swindonmakers/SCOB/README.md

# SCOB
BOB-inspired mobile robot designed in OpenSCAD

[Full assembly, printing and sourcing guides in the documentation](http://rawgit.com/snhack/SCOB/master/hardware/docs/index.htm)

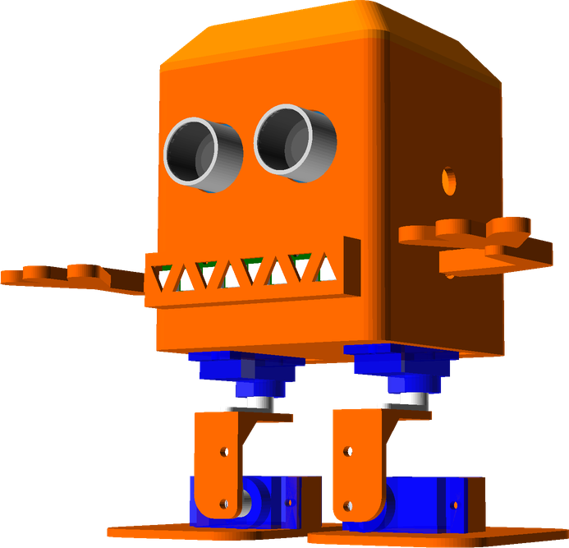
[picture p1: hardware/images/SCOB_view.png]
