swindonmakers/SCOB/hardware/docs/SCOBSourcingGuide.md

# SCOB
# Sourcing Guide

### 1x Arduino Pro Mini Pins on top, inc serial pins

Unit Cost | Source | Notes 
--- | --- | --- 
3 | [link](http://www.aliexpress.com/item/CP2102-Module-Pro-Mini-Module-Atmega328-3-3V-8M-For-Arduinoi-Compatible-With-Nano-Free-Shipping/2002847394.html) | Use 3.3v version for wider compatibility and longer battery life

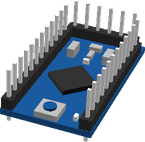
[picture p6: hardware/vitamins/images/ArduinoProMiniPinsontopincserialpins_view.png]
 

### 4x AA Battery

Unit Cost | Source | Notes 
--- | --- | --- 
0.35 | All over the place | Use rechargeables to save cost

 

### 1x Battery Pack

Unit Cost | Source | Notes 
--- | --- | --- 
0.49 | [link](http://www.aliexpress.com/item/Black-Color-2-2-AA-Battery-1-5V-Holder-Storage-Boxes-for-DIY-Experiment-Test-Cascade/1981330624.html) | Any 4xAA pack should work fine, or use 2S LIPO, NIMH, NICAD, etc

 

### 1x HCSR04 Ultrasonic Sensor

No sources found

 

### 4x 9g Micro Servo

No sources found

 

### 1x SPST6A Mini Toggle Switch

Unit Cost | Source | Notes 
--- | --- | --- 
0.56 | [link](http://www.ebay.co.uk/itm/10x-Mini-Toggle-Switch-6A-SPST-ON-OFF-/251443706793?) | Buy in bulk x10

 

### 1x NeoPixel Strip8

No sources found

 

### 4x Servo Horn

No sources found

 

## Summary

### Total Costs

Metric | Value 
--- | --- 
Total Vitamins | 17
Total Cost (cheapest) | 5.45 GBP
