swindonmakers/SCOB/hardware/docs/BOBOSourcingGuide.md

# BOBO
# Sourcing Guide

### 1x Arduino Pro Mini Pins underneath, inc serial pins

No sources found

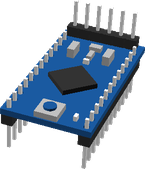
[picture p7: hardware/vitamins/images/ArduinoProMiniPinsunderneathincserialpins_view.png]
 

### 4x AAA Battery

No sources found

 

### 1x HCSR04 Ultrasonic Sensor

No sources found

 

### 2x 9g Micro Servo

No sources found

 

### 1x SPST6A Mini Toggle Switch

Unit Cost | Source | Notes 
--- | --- | --- 
0.56 | [link](http://www.ebay.co.uk/itm/10x-Mini-Toggle-Switch-6A-SPST-ON-OFF-/251443706793?) | Buy in bulk x10

 

## Summary

### Total Costs

Metric | Value 
--- | --- 
Total Vitamins | 9
Total Cost (cheapest) | 0.56 GBP
