swindonmakers/SCOB/hardware/printedparts/stl/NeoPixelMouth.stl

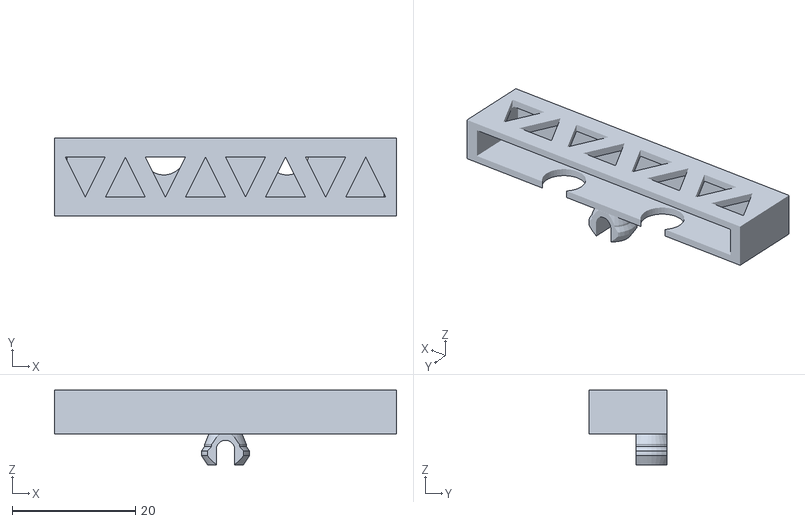
[picture p8: CAD file, 2015-09-18]
hardware/printedparts/stl/NeoPixelMouth.stl
55.5 x 12.7 x 12.2
