swindonmakers/SCOB/hardware/ref/Base__repaired_.stl

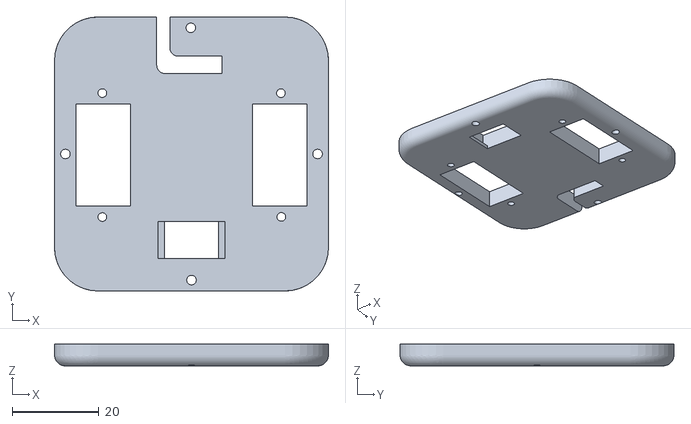
[picture p9: CAD file, 2015-08-27]
hardware/ref/Base__repaired_.stl
63.0 x 63.0 x 5.00
