swindonmakers/SCOB/hardware/utils/surfacesolids/curve_section.stl

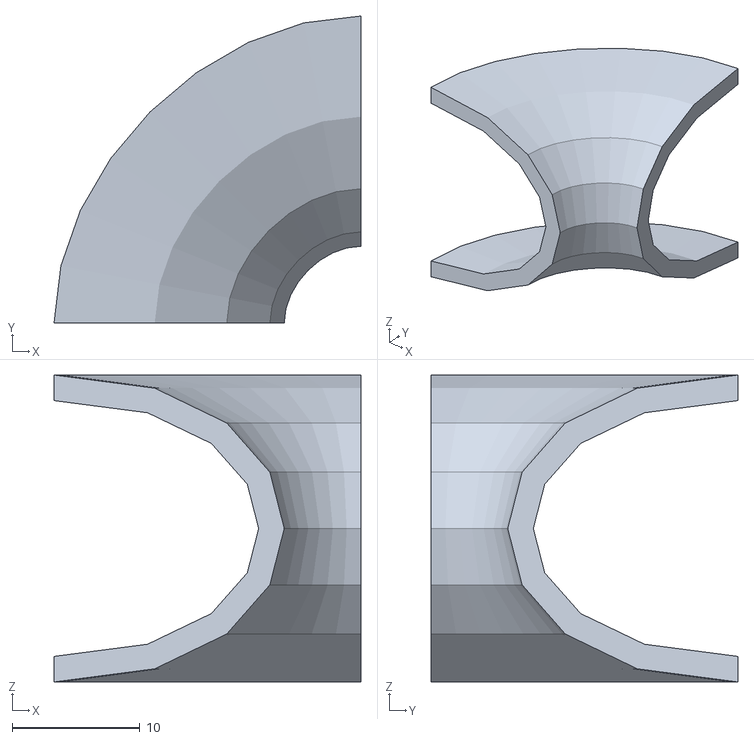
[picture p10: CAD file, 2015-08-27]
hardware/utils/surfacesolids/curve_section.stl
24.0 x 24.0 x 24.0
