swindonmakers/SCOB/hardware/vitamins/stl/ServoHorn_Part.stl

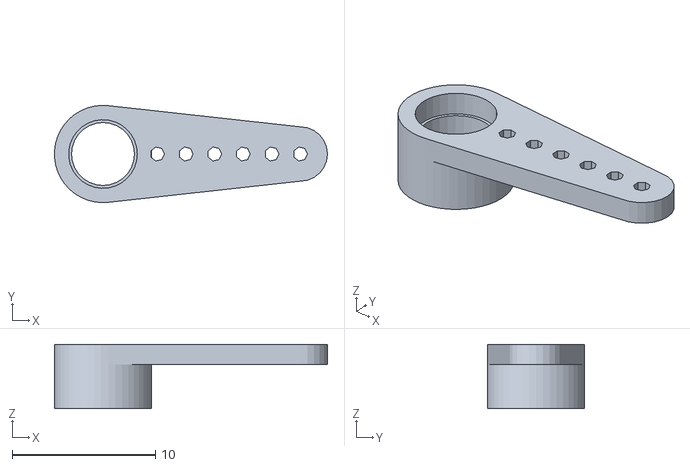
[picture p11: CAD file, 2015-11-09]
hardware/vitamins/stl/ServoHorn_Part.stl
19.1 x 6.80 x 4.50
