swindonmakers/SCOB/hardware/printedparts/stl/ZombieArm.stl

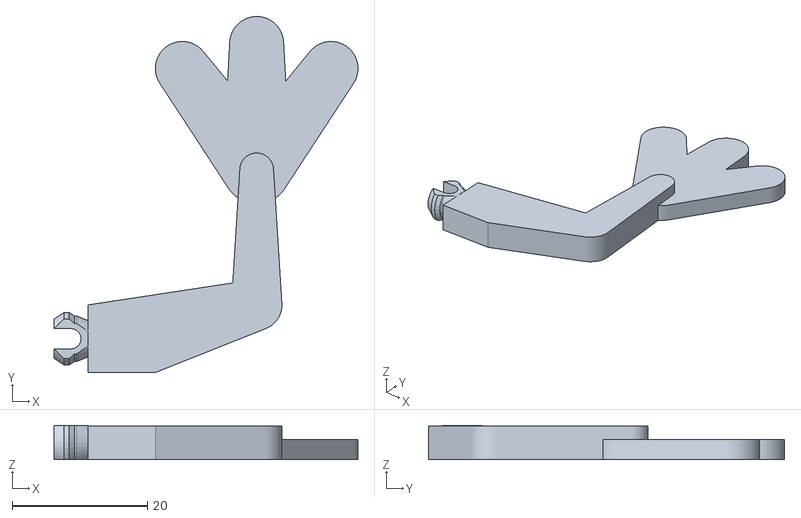
[picture p12: CAD file, 2015-09-18]
hardware/printedparts/stl/ZombieArm.stl
45.0 x 52.7 x 5.05
