swindonmakers/SCOB/hardware/ref/Head__repaired_.stl

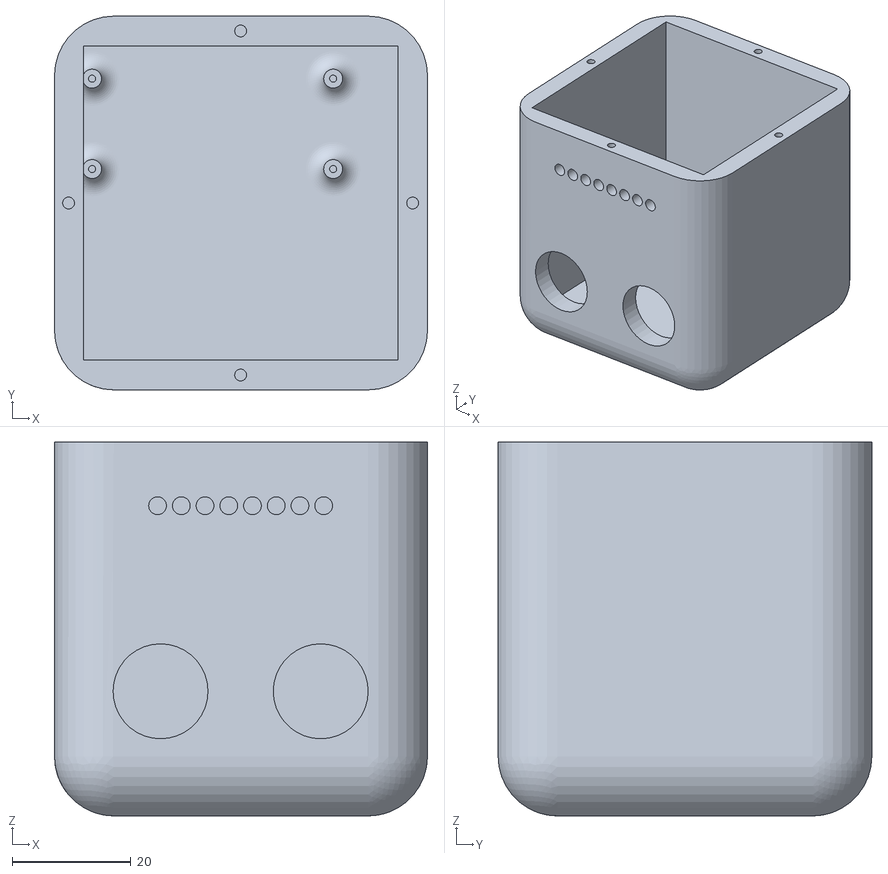
[picture p13: CAD file, 2015-08-27]
hardware/ref/Head__repaired_.stl
62.9 x 63.0 x 63.0
