swindonmakers/SCOB/hardware/vitamins/stl/MicroServo_Body.stl

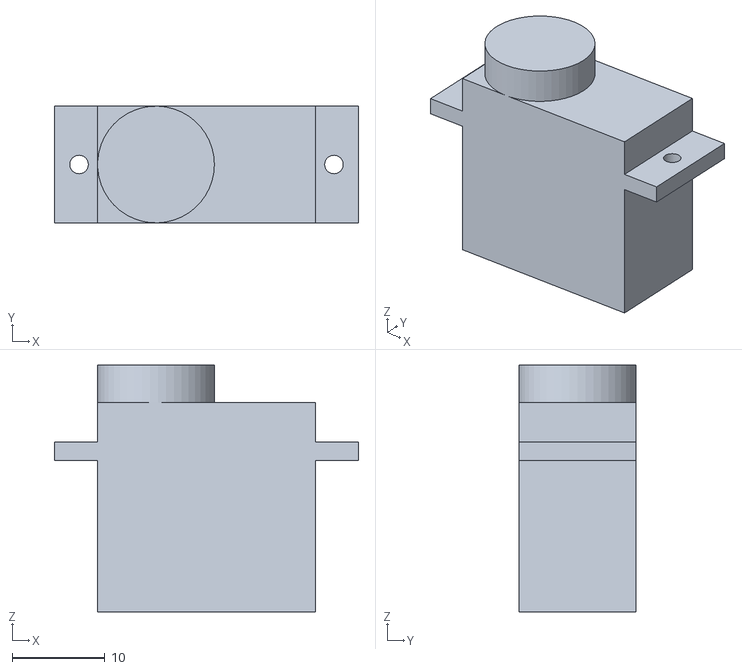
[picture p14: CAD file, 2015-08-27]
hardware/vitamins/stl/MicroServo_Body.stl
32.8 x 12.6 x 26.6
