swindonmakers/SCOB/hardware/printedparts/stl/FlexyArm.stl

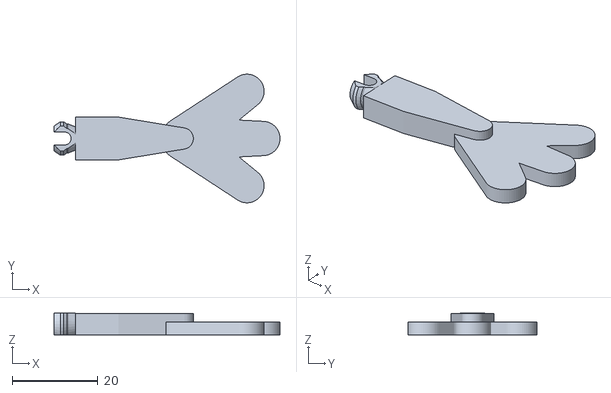
[picture p15: CAD file, 2015-09-18]
hardware/printedparts/stl/FlexyArm.stl
52.7 x 30.0 x 5.05
