swindonmakers/SCOB/hardware/ref/Foot__repaired_.stl

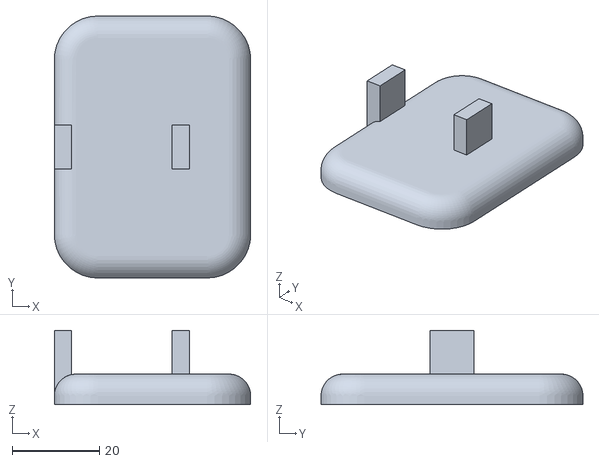
[picture p16: CAD file, 2015-08-27]
hardware/ref/Foot__repaired_.stl
45.0 x 60.0 x 17.0
