swindonmakers/SCOB/hardware/vitamins/stl/MicroServo_Spline.stl

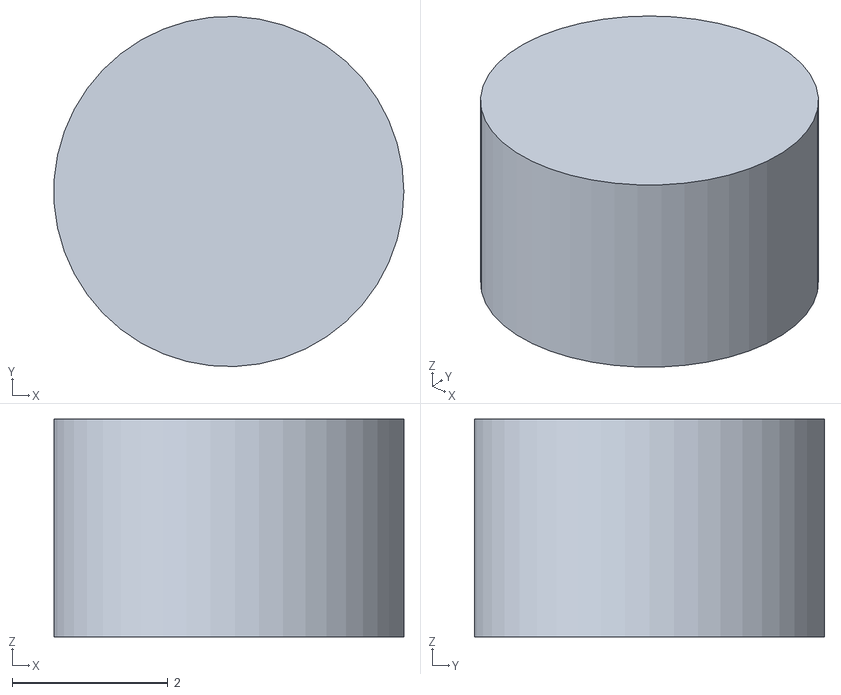
[picture p17: CAD file, 2015-08-27]
hardware/vitamins/stl/MicroServo_Spline.stl
4.49 x 4.50 x 2.80
