swindonmakers/SCOB/hardware/printedparts/stl/Hat.stl

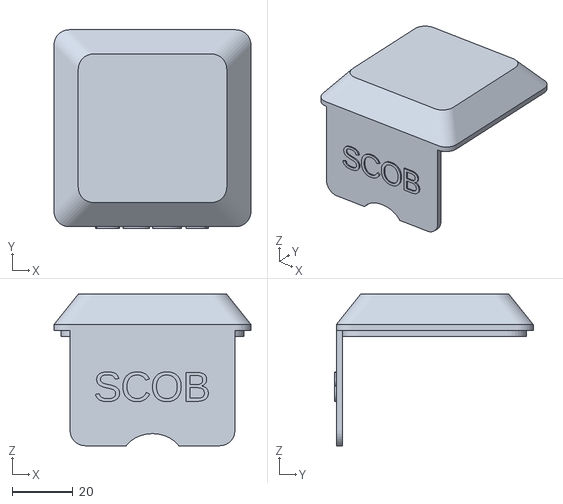
[picture p18: CAD file, 2015-09-18]
hardware/printedparts/stl/Hat.stl
65.0 x 65.5 x 50.0
