swindonmakers/SCOB/hardware/ref/Leg_LH__repaired_.stl

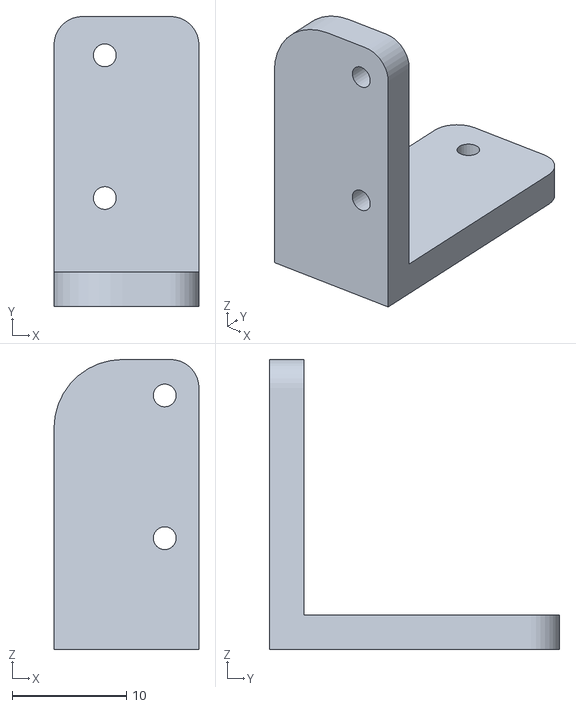
[picture p19: CAD file, 2015-08-27]
hardware/ref/Leg_LH__repaired_.stl
12.7 x 25.4 x 25.4
