swindonmakers/SCOB/hardware/printedparts/stl/Head.stl

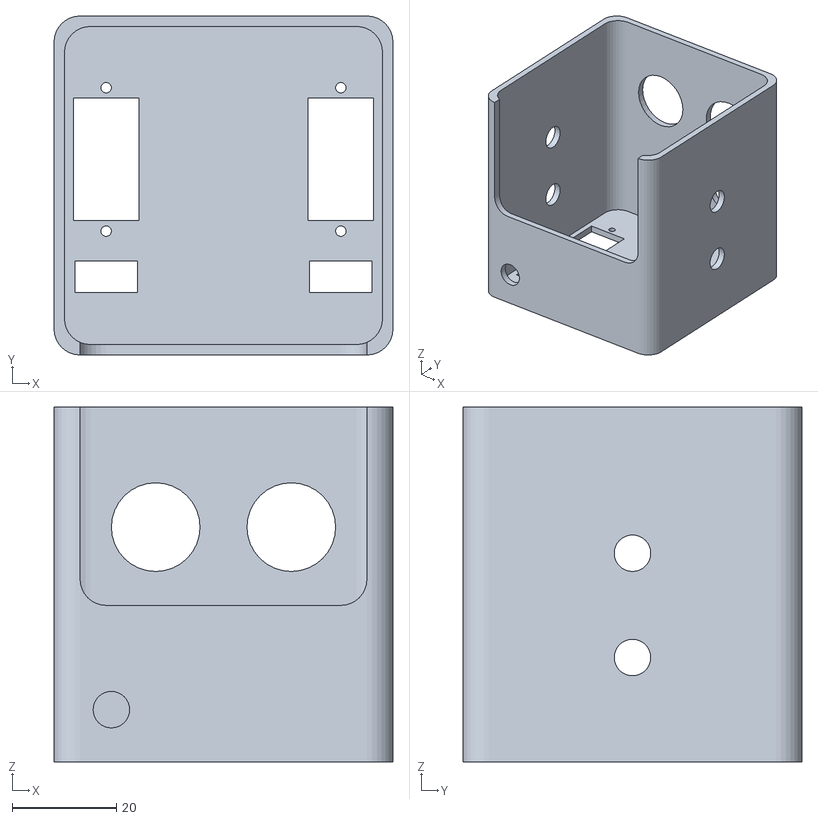
[picture p20: CAD file, 2015-09-18]
hardware/printedparts/stl/Head.stl
65.0 x 65.0 x 68.0
