swindonmakers/SCOB/hardware/printedparts/stl/LeftLeg.stl

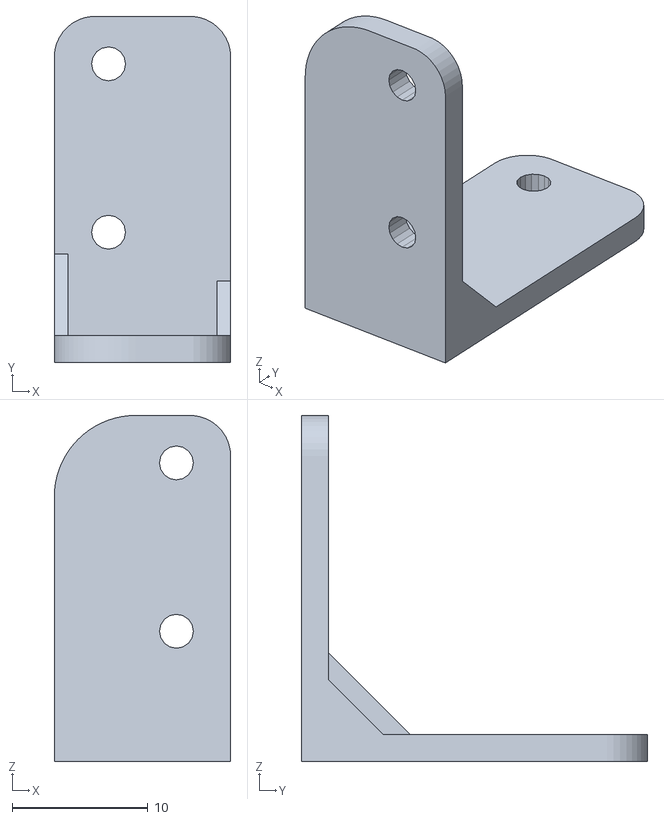
[picture p21: CAD file, 2015-08-28]
hardware/printedparts/stl/LeftLeg.stl
13.0 x 25.5 x 25.5
