swindonmakers/SCOB/hardware/printedparts/stl/Foot.stl

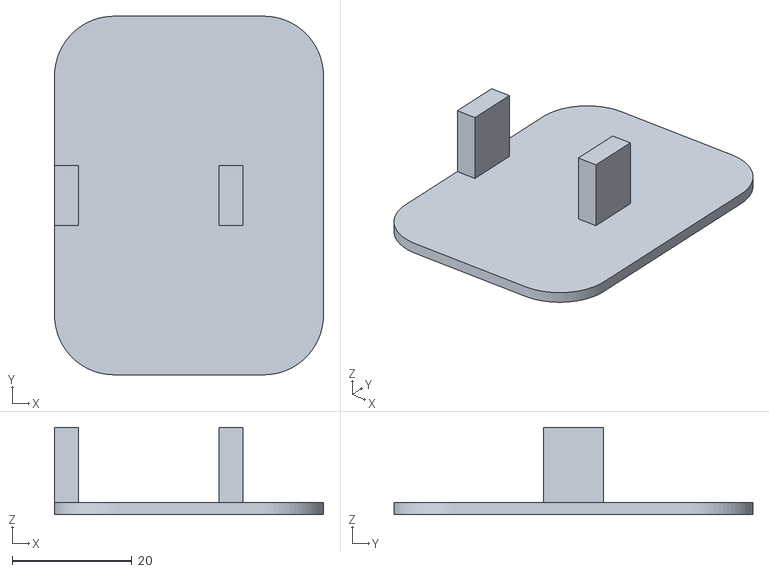
[picture p22: CAD file, 2015-08-28]
hardware/printedparts/stl/Foot.stl
45.0 x 60.0 x 14.6
