swindonmakers/SCOB/hardware/assemblies/Final.scad

Head_Con_Arduino = [[0,0,38], [0,0,-1], 180,0,0];

Head_Con_BatteryPack = [[-8.5,-Head_Depth/2 + 3,24], [0,-1,0], 0,0,0];

module FinalAssembly (zombie=true) {

    assembly("assemblies/Final.scad", "Final", str("FinalAssembly()")) {

        // base part
        Head_STL();

        // steps
        step(1, "Insert sensor") {
            view(t=[0,0,0], r=[52,0,218], d=400);

            attach(Head_Con_SensorTX, HCSR04UltrasonicSensor_Con_TXCan)
                HCSR04UltrasonicSensor();
        }

        // insert left servo
        step(2, "Left servo") {
            view();

            attach(Head_Con_LeftServo, MicroServo_Con_Fixing1) {
                MicroServo();
                attach(MicroServo_Con_Horn, DefConDown)
                    ServoHorn();
            }
        }

        // insert right servo
        step(3, "Right servo") {
            view();

            attach(Head_Con_RightServo, MicroServo_Con_Fixing1) {
                MicroServo();
                attach(MicroServo_Con_Horn, DefConDown)
                    ServoHorn();
            }
        }

        step(4, "Power switch") {
            view();

            attach(Head_Con_PowerSwitch, MiniToggleSwitch_Con_Def)
                MiniToggleSwitch(washerOffset=dw);
        }

        step(5, "Shove in an Arduino") {
            view();

            attach(Head_Con_Arduino, ArduinoPro_Con_Center)
                ArduinoPro(headerpins=2, serialpins=1);
        }


        step(6, "Followed by a battery pack") {
            view();

            attach(Head_Con_BatteryPack,DefConDown)
                 BatteryPack(BP=BatteryPack_AA_4_SQ, showBatteries=true);
        }

        step(7, "Attach the legs") {
            view();

            attach(Head_Con_LeftServo, MicroServo_Con_Fixing1) {
                attach(
                    rollConnector(MicroServo_Con_Horn, -90),
                    offsetConnector(invertConnector(LeftLeg_Con_Hip), [0,0,-4.5])
                ) {
                    LeftLeg_STL();

                    attach(LeftLeg_Con_Ankle, LeftFootAssembly_Con_Servo)
                        LeftLegAssembly();
                }

            }

            attach(Head_Con_RightServo, MicroServo_Con_Fixing1) {
                attach(
                    rollConnector(MicroServo_Con_Horn, -90),
                    offsetConnector(invertConnector(RightLeg_Con_Hip), [0,0,-4.5])
                ) {
                    RightLeg_STL();

                    attach(RightLeg_Con_Ankle, RightFootAssembly_Con_Servo)
                        RightLegAssembly();
                }
            }
        }

        step(8, "Add a hat") {
            view();

            attach(Head_Con_Hat, Hat_Con_Def, ExplodeSpacing = 50)
                Hat_STL();
        }

		step(9, "Attach arms") {
			view();

            if (zombie) {
                attach(rollConnector(Head_Con_LeftArm, 180), FlexyArm_Con_Def)
    				ZombieArm_STL();

    			attach(rollConnector(Head_Con_RightArm, 0), FlexyArm_Con_Def)
    				ZombieArm_STL();
            } else {
                attach(rollConnector(Head_Con_LeftArm, -90), FlexyArm_Con_Def)
    				FlexyArm_STL();

    			attach(rollConnector(Head_Con_RightArm, 90), FlexyArm_Con_Def)
    				FlexyArm_STL();
            }

		}
		
		step(10, "Attach mouth") {
			view();
			
			attach(rollConnector(Head_Con_Mouth, 180), NeoPixelMouthAssembly_Con)
				NeoPixelMouthAssembly();
		}
    }
}
