swindonmakers/SCOB/hardware/config/assemblies.scad

//
// Assemblies
//

// Add list of include statements like this:
//include <../assemblies/myassembly.scad>

// Order the include statements such that the lowest sub-assemblies are first
include <../assemblies/Final.scad>
include <../assemblies/LeftLeg.scad>
include <../assemblies/RightLeg.scad>
include <../assemblies/NeoPixelMouth.scad>
