swindonmakers/SCOB/hardware/config/printedparts.scad

// Printed Parts
//
// Order alphabetically - printed parts should not have inter-dependencies!
include <../printedparts/FlexyArm.scad>
include <../printedparts/Head.scad>
include <../printedparts/LeftLeg.scad>
include <../printedparts/RightLeg.scad>
include <../printedparts/Foot.scad>
include <../printedparts/Hat.scad>
include <../printedparts/PinTack.scad>
include <../printedparts/ZombieArm.scad>
include <../printedparts/NeoPixelMouth.scad>
