swindonmakers/SCOB/hardware/config/vitamins.scad

//
// Vitamins

include <../vitamins/HCSR04UltrasonicSensor.scad>
include <../vitamins/MicroServo.scad>
include <../vitamins/MiniToggleSwitch.scad>
include <../vitamins/NeoPixel.scad>
include <../vitamins/ArduinoPro.scad>
include <../vitamins/Battery.scad>
include <../vitamins/BatteryPack.scad>
include <../vitamins/ServoHorn.scad>
