swindonmakers/SCOB/hardware/sandbox/assembly_LeftLegAssembly.scad

include <../config/config.scad>
UseSTL=false;
UseVitaminSTL=true;
DebugConnectors=true;
DebugCoordinateFrames=true;
LeftLegAssembly();
