swindonmakers/SCOB/hardware/sandbox/assembly_RightLegAssembly.scad

include <../config/config.scad>
UseSTL=false;
UseVitaminSTL=true;
DebugConnectors=true;
DebugCoordinateFrames=true;
RightLegAssembly();
