swindonmakers/SCOB/hardware/sandbox/printedpart_FlexyArm.scad

include <../config/config.scad>
UseSTL=false;
UseVitaminSTL=true;
DebugConnectors=true;
DebugCoordinateFrames=true;

FlexyArm_STL();
