swindonmakers/SCOB/hardware/sandbox/printedpart_LeftLeg.scad

include <../config/config.scad>
UseSTL=false;
UseVitaminSTL=true;
DebugConnectors=true;
DebugCoordinateFrames=true;
LeftLeg_STL();
