swindonmakers/SCOB/hardware/sandbox/printedpart_RightLeg.scad

include <../config/config.scad>
UseSTL=false;
UseVitaminSTL=true;
DebugConnectors=true;
DebugCoordinateFrames=true;
RightLeg_STL();
