swindonmakers/SCOB/hardware/sandbox/printedpart_ZombieArm.scad

include <../config/config.scad>
UseSTL=false;
UseVitaminSTL=true;
DebugConnectors=true;
DebugCoordinateFrames=true;
ZombieArm_STL();
