swindonmakers/SCOB/hardware/sandbox/assembly_FinalAssembly.scad

include <../config/config.scad>
UseSTL=false;
UseVitaminSTL=true;
DebugConnectors=true;
DebugCoordinateFrames=true;
FinalAssembly();
