swindonmakers/SCOB/hardware/sandbox/assembly_NeoPixelMouth.scad

include <../config/config.scad>
UseSTL=false;
UseVitaminSTL=true;
DebugConnectors=true;
DebugCoordinateFrames=true;
NeoPixelMouthAssembly();
