swindonmakers/SCOB/hardware/sandbox/printedpart_Foot.scad

include <../config/config.scad>
UseSTL=false;
UseVitaminSTL=true;
DebugConnectors=true;
DebugCoordinateFrames=true;
Foot_STL();
