swindonmakers/SCOB/hardware/sandbox/printedpart_Hat.scad

include <../config/config.scad>
UseSTL=false;
UseVitaminSTL=true;
DebugConnectors=true;
DebugCoordinateFrames=true;
Hat_STL();
