swindonmakers/SCOB/hardware/sandbox/printedpart_Head.scad

include <../config/config.scad>
UseSTL=false;
UseVitaminSTL=true;
DebugConnectors=true;
DebugCoordinateFrames=true;
Head_STL();
