swindonmakers/SCOB/hardware/sandbox/zombieSCOB.scad

include <../config/config.scad>
UseSTL=false;
UseVitaminSTL=true;
DebugConnectors=false;
DebugCoordinateFrames=false;
FinalAssembly(zombie=true);
