swindonmakers/SCOB/(list of files, cad)

Other CAD files:
hardware/ref/Leg_RH__repaired_.stl
hardware/printedparts/stl/RightLeg.stl
hardware/printedparts/RightLeg.scad
hardware/SCOBExtras.scad
hardware/ci/assemblies.scad
hardware/ci/assembly.scad
hardware/ci/cutpart.scad
hardware/ci/cutparts.scad
hardware/ci/machine.scad
hardware/ci/printedpart.scad
hardware/ci/printedparts.scad
hardware/ci/root.scad
hardware/ci/sandbox.scad
hardware/ci/test.scad
hardware/ci/vitamin.scad
hardware/ci/vitamins.scad
hardware/config/colors.scad
hardware/config/config.scad
hardware/config/cutparts.scad
hardware/config/holesizes.scad
hardware/config/utils.scad
hardware/printedparts/PinTack.scad
hardware/utils/assemblies.scad
hardware/utils/bezier.scad
hardware/utils/bezier_demo.scad
hardware/utils/fakeGroundShadow.scad
hardware/utils/maths.scad
hardware/utils/pins.scad
hardware/utils/surfacesolids/Demo_Renderer.scad
hardware/utils/surfacesolids/Renderer.scad
hardware/utils/surfacesolids/maths.scad
hardware/utils/surfacesolids/ribbonCable.scad
hardware/utils/voronoi.scad
hardware/vitamins/ArduinoPro.scad
hardware/vitamins/BatteryPack.scad
hardware/vitamins/Bolt.scad
hardware/vitamins/Breadboard.scad
hardware/vitamins/ESP8266.scad
hardware/vitamins/FTDIBreakout.scad
hardware/vitamins/HookAndLoopTape.scad
hardware/vitamins/JumperWire.scad
hardware/vitamins/LED.scad
hardware/vitamins/LEDClip.scad
hardware/vitamins/LineSensor.scad
hardware/vitamins/Marble.scad
hardware/vitamins/MicroSwitch.scad
hardware/vitamins/MicroUSB.scad
hardware/vitamins/MiniToggleSwitch.scad
hardware/vitamins/Nut.scad
hardware/vitamins/Pen.scad
hardware/vitamins/PlasticCaster.scad
hardware/vitamins/Sharp2Y0A21IrDistanceSensor.scad
hardware/vitamins/SlideSwitch.scad
hardware/vitamins/TerminalBlock.scad
hardware/vitamins/ULN2003DriverBoard.scad
hardware/vitamins/motor.scad
hardware/vitamins/murata-piezos.scad
hardware/vitamins/screw.scad
hardware/vitamins/washer.scad
