swindonmakers/SCOB/hardware/docs/SCOBAssemblyGuide.md

# SCOB
# Assembly Guide

view

## Bill of Materials

Make sure you have all of the following parts before you begin.

### Vitamins

Qty | Vitamin | Image
--- | --- | ---
1 | [Arduino Pro Mini Pins on top, inc serial pins]() |  | 
4 | [AA Battery]() |  | 
1 | [Battery Pack]() |  | 
1 | [HCSR04 Ultrasonic Sensor]() |  | 
4 | [9g Micro Servo]() |  | 
1 | [SPST6A Mini Toggle Switch]() |  | 
1 | [NeoPixel Strip8]() |  | 
4 | [Servo Horn]() |  | 

### Printed Parts

Qty | Part Name | Image
--- | --- | ---
2 | [Foot](../printedparts/stl/Foot.stl) |  | 
1 | [Hat](../printedparts/stl/Hat.stl) |  | 
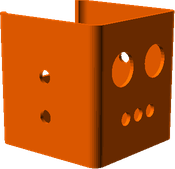
[picture p23: hardware/printedparts/images/Head_view.png]
1 | [Head](../printedparts/stl/Head.stl) |  | 
1 | [Left Leg](../printedparts/stl/LeftLeg.stl) |  | 
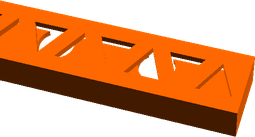
[picture p24: hardware/printedparts/images/NeoPixelMouth_view.png]
1 | [NeoPixelMouth](../printedparts/stl/NeoPixelMouth.stl) |  | 
1 | [Right Leg](../printedparts/stl/RightLeg.stl) |  | 
2 | [Zombie Arm](../printedparts/stl/ZombieArm.stl) |  | 

**Plastic Required**

79.5cm3, 0.1KG,  approx: 1.29 GBP

# Assembly Instructions

## Left Leg

### Vitamins

Qty | Vitamin | Image
--- | --- | ---
1 | [9g Micro Servo]() |  | 
1 | [Servo Horn]() |  | 

### Printed Parts

Qty | Part Name | Image
--- | --- | ---
1 | [Foot](../printedparts/stl/Foot.stl) |  | 

### Assembly Steps

1. Fix servo to foot
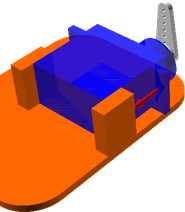
[picture p25: hardware/assemblies/SCOB/LeftLeg_step1_view.png]


## Right Leg

### Vitamins

Qty | Vitamin | Image
--- | --- | ---
1 | [9g Micro Servo]() |  | 
1 | [Servo Horn]() |  | 

### Printed Parts

Qty | Part Name | Image
--- | --- | ---
1 | [Foot](../printedparts/stl/Foot.stl) |  | 

### Assembly Steps

1. Fix servo to foot
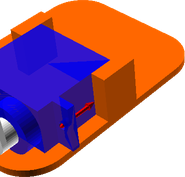
[picture p26: hardware/assemblies/SCOB/RightLeg_step1_view.png]


## Neo Pixel Mouth

### Vitamins

Qty | Vitamin | Image
--- | --- | ---
1 | [NeoPixel Strip8]() |  | 

### Printed Parts

Qty | Part Name | Image
--- | --- | ---
1 | [NeoPixelMouth](../printedparts/stl/NeoPixelMouth.stl) |  | 

### Assembly Steps

1. Insert Neo Pixel Strip
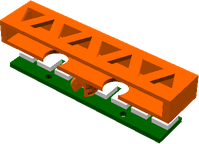
[picture p27: hardware/assemblies/SCOB/NeoPixelMouth_step1_view.png]


## Final

### Vitamins

Qty | Vitamin | Image
--- | --- | ---
1 | [Arduino Pro Mini Pins on top, inc serial pins]() |  | 
4 | [AA Battery]() |  | 
1 | [Battery Pack]() |  | 
1 | [HCSR04 Ultrasonic Sensor]() |  | 
2 | [9g Micro Servo]() |  | 
1 | [SPST6A Mini Toggle Switch]() |  | 
2 | [Servo Horn]() |  | 

### Printed Parts

Qty | Part Name | Image
--- | --- | ---
1 | [Hat](../printedparts/stl/Hat.stl) |  | 
1 | [Head](../printedparts/stl/Head.stl) |  | 
1 | [Left Leg](../printedparts/stl/LeftLeg.stl) |  | 
1 | [Right Leg](../printedparts/stl/RightLeg.stl) |  | 
2 | [Zombie Arm](../printedparts/stl/ZombieArm.stl) |  | 

### Sub-Assemblies

Qty | Name 
--- | --- 
1 | Left Leg
1 | Right Leg
1 | Neo Pixel Mouth

### Assembly Steps

1. Insert sensor
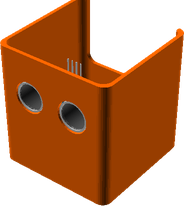
[picture p28: hardware/assemblies/SCOB/Final_step1_view.png]

2. Left servo
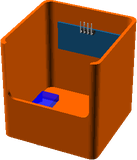
[picture p29: hardware/assemblies/SCOB/Final_step2_view.png]

3. Right servo
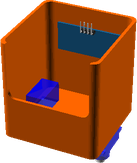
[picture p30: hardware/assemblies/SCOB/Final_step3_view.png]

4. Power switch
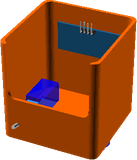
[picture p31: hardware/assemblies/SCOB/Final_step4_view.png]

5. Shove in an Arduino
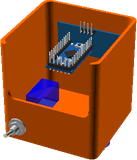
[picture p32: hardware/assemblies/SCOB/Final_step5_view.png]

6. Followed by a battery pack
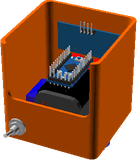
[picture p33: hardware/assemblies/SCOB/Final_step6_view.png]

7. Attach the legs
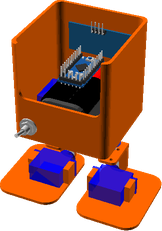
[picture p34: hardware/assemblies/SCOB/Final_step7_view.png]

8. Add a hat
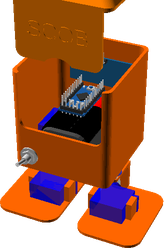
[picture p35: hardware/assemblies/SCOB/Final_step8_view.png]

9. Attach arms
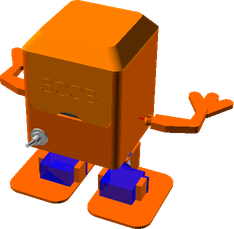
[picture p36: hardware/assemblies/SCOB/Final_step9_view.png]

10. Attach mouth
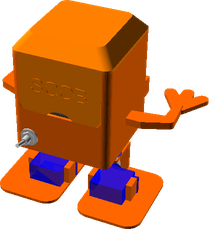
[picture p37: hardware/assemblies/SCOB/Final_step10_view.png]
