swindonmakers/SCOB/hardware/docs/SCOBPrintingGuide.md

# SCOB
# Printing Guide

### Foot

Metric | Value 
--- | --- 
Quantity | 2
STL | [Foot](../printedparts/stl/Foot.stl)
Plastic (Kg) | 0.02
Plastic (cm3) | 13.0
Approx Plastic Cost | 0.24 GBP



### Hat

Metric | Value 
--- | --- 
Quantity | 1
STL | [Hat](../printedparts/stl/Hat.stl)
Plastic (Kg) | 0.02
Plastic (cm3) | 19.4
Approx Plastic Cost | 0.36 GBP



### Head

Metric | Value 
--- | --- 
Quantity | 1
STL | [Head](../printedparts/stl/Head.stl)
Plastic (Kg) | 0.05
Plastic (cm3) | 38.7
Approx Plastic Cost | 0.73 GBP



### Left Leg

Metric | Value 
--- | --- 
Quantity | 1
STL | [Left Leg](../printedparts/stl/LeftLeg.stl)
Plastic (Kg) | 0.0
Plastic (cm3) | 1.3
Approx Plastic Cost | 0.02 GBP



### NeoPixelMouth

Metric | Value 
--- | --- 
Quantity | 1
STL | [NeoPixelMouth](../printedparts/stl/NeoPixelMouth.stl)



### Right Leg

Metric | Value 
--- | --- 
Quantity | 1
STL | [Right Leg](../printedparts/stl/RightLeg.stl)
Plastic (Kg) | 0.0
Plastic (cm3) | 1.3
Approx Plastic Cost | 0.02 GBP



### Zombie Arm

Metric | Value 
--- | --- 
Quantity | 2
STL | [Zombie Arm](../printedparts/stl/ZombieArm.stl)
Plastic (Kg) | 0.01
Plastic (cm3) | 5.8
Approx Plastic Cost | 0.11 GBP



## Summary

### Statistics

Metric | Value 
--- | --- 
Total Parts | 9
Total Plastic (Kg) | 0.1KG
Total Plastic (cm3) | 79.5cm3
Approx Plastic Cost | 1.49 GBP
