swindonmakers/SCOB/hardware/docs/SCOBExtrasAssemblyGuide.md

# SCOB Extras
# Assembly Guide

view

## Bill of Materials

Make sure you have all of the following parts before you begin.

### Printed Parts

Qty | Part Name | Image
--- | --- | ---
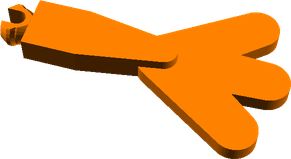
[picture p38: hardware/printedparts/images/FlexyArm_view.png]
1 | [FlexyArm](../printedparts/stl/FlexyArm.stl) |  | 

**Plastic Required**

2.2cm3, 0.0KG,  approx: 0.04 GBP
