swindonmakers/SCOB/hardware/docs/SCOBExtrasPrintingGuide.md

# SCOB Extras
# Printing Guide

### FlexyArm

Metric | Value 
--- | --- 
Quantity | 1
STL | [FlexyArm](../printedparts/stl/FlexyArm.stl)
Plastic (Kg) | 0.0
Plastic (cm3) | 2.2
Approx Plastic Cost | 0.04 GBP



## Summary

### Statistics

Metric | Value 
--- | --- 
Total Parts | 1
Total Plastic (Kg) | 0.0KG
Total Plastic (cm3) | 2.2cm3
Approx Plastic Cost | 0.04 GBP
