swindonmakers/SCOB/hardware/docs/BOBOAssemblyGuide.md

# BOBO
# Assembly Guide

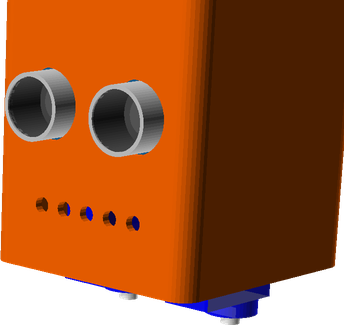
[picture p39: hardware/images/BOBO_view.png]
view


## Bill of Materials

Make sure you have all of the following parts before you begin.

### Vitamins

Qty | Vitamin | Image
--- | --- | ---
1 | [Arduino Pro Mini Pins underneath, inc serial pins]() |  | 
4 | [AAA Battery]() |  | 
1 | [HCSR04 Ultrasonic Sensor]() |  | 
2 | [9g Micro Servo]() |  | 
1 | [SPST6A Mini Toggle Switch]() |  | 

### Printed Parts

Qty | Part Name | Image
--- | --- | ---
1 | [Head](../printedparts/stl/Head.stl) |  | 

**Plastic Required**

38.7cm3, 0.05KG,  approx: 0.63 GBP

# Assembly Instructions

## Final

### Vitamins

Qty | Vitamin | Image
--- | --- | ---
1 | [Arduino Pro Mini Pins underneath, inc serial pins]() |  | 
4 | [AAA Battery]() |  | 
1 | [HCSR04 Ultrasonic Sensor]() |  | 
2 | [9g Micro Servo]() |  | 
1 | [SPST6A Mini Toggle Switch]() |  | 

### Printed Parts

Qty | Part Name | Image
--- | --- | ---
1 | [Head](../printedparts/stl/Head.stl) |  | 

### Assembly Steps

1. Insert sensor
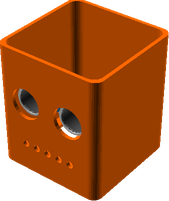
[picture p40: hardware/assemblies/BOBO/Final_step1_view.png]

2. Left servo
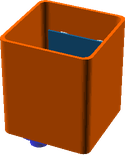
[picture p41: hardware/assemblies/BOBO/Final_step2_view.png]

3. Right servo
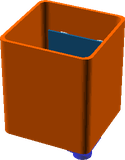
[picture p42: hardware/assemblies/BOBO/Final_step3_view.png]

4. Power switch
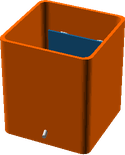
[picture p43: hardware/assemblies/BOBO/Final_step4_view.png]

5. Shove in an Arduino
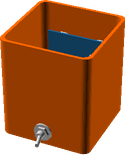
[picture p44: hardware/assemblies/BOBO/Final_step5_view.png]

6. Followed by a battery pack
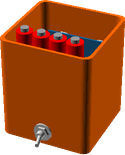
[picture p45: hardware/assemblies/BOBO/Final_step6_view.png]
