swindonmakers/SCOB/hardware/docs/BOBOPrintingGuide.md

# BOBO
# Printing Guide

### Head

Metric | Value 
--- | --- 
Quantity | 1
STL | [Head](../printedparts/stl/Head.stl)
Plastic (Kg) | 0.05
Plastic (cm3) | 38.7
Approx Plastic Cost | 0.73 GBP



## Summary

### Statistics

Metric | Value 
--- | --- 
Total Parts | 1
Total Plastic (Kg) | 0.05KG
Total Plastic (cm3) | 38.7cm3
Approx Plastic Cost | 0.73 GBP
