swindonmakers/SCOB/(commit log)

2015-08-27 Initial commit - basic part files defined
    [ArduinoPro.scad, BOBO.scad, Battery.scad, BatteryPack.scad, Bolt.scad, Breadboard.scad, Demo_Renderer.scad, ESP8266.scad]
2015-08-27 Draft head complete
    [Battery.scad, Final.scad, HCSR04UltrasonicSensor.scad, Head.scad, MicroServo.scad, machine.scad, vitamins.scad]
2015-08-27 Initial build
    [Head.stl, MicroServo_Body.stl, MicroServo_Spline.stl]
2015-08-27 Fixes post rename to SCOB
    [SCOB.scad]
2015-08-27 Mr Potato Head inspired pin holes
    Nose, mouth, arms, ears
    [Final.scad, Head.scad, PinTack.scad, machine.scad, printedparts.scad]
2015-08-27 Feet modelled and leg assemblies started
    [Base__repaired_.stl, Final.scad, Foot.scad, Foot__repaired_.stl, Head__repaired_.stl, LeftLeg.scad, Leg_LH__repaired_.stl, Leg_RH__repaired_.stl]
2015-08-27 Started on LeftLeg
    Determined basic dimensions
    [LeftLeg.scad]
2015-08-28 Workable software, tweaks to head design
    [Foot.stl, Head.scad, Head.stl, SCOB.scad, machine.scad]
2015-08-28 Added legs, updated utils
    [Final.scad, LeftLeg.scad, LeftLeg.stl, RightLeg.scad, RightLeg.stl, attach.scad, moreShapes.scad, vector.scad]
2015-09-02 Splitting out servo animation library
    doesn’t yet work - DO NOT USE!!!
    [SCOB.ino, ServoAnimator.h]
2015-09-02 ServoAnimator working, SCOB app extended
2015-09-03 Increased head width by 5mm
    to better accommodate 2x2 or 1x4 AAA battery packs
    [Head.stl, machine.scad]
2015-09-03 Basic interactive state, POS command
    POS <servo> <relative position>
2015-09-04 bugfix: Use correct variable
    [SCOB.ino]
2015-09-04 Oops, revert commit of local config changes
    [Config.h]
2015-09-04 Make TL stay up high for a short while.
    [Animations.h]
2015-09-05 Ability to reverse animations, BK now works
    [SCOB.ino, ServoAnimator.h]
2015-09-05 Servo enters saved and loaded from EEPROM
    Configure servo centers with:
    SC <servo> <center>
    Save config to EEPROM with:
    SV
    Loaded automatically after first save
2015-09-05 Added TO command
    takes 4 servo positions (relative) and duration of move in ms:
    TO <lhip> <lankle> <rankle> <rhip> <dur>
2015-09-05 Basic host program in processing
    Fleshing out a little host program to allow easy creation of new
    animations…
2015-09-06 Added joint sliders
2015-09-07 Reset and reload animation values
    [SCOBAnimationDesigner.pde]
2015-09-07 Animations for lookLeft and lookRight
    ready to hook up to sonar readings
2015-09-08 Added missing commas to clipboard function
    [SCOBAnimationDesigner.pde]
2015-09-08 Regular sonar readings
    reading every 200ms (ish), last reading and averaged reading available
    for behaviour routines
2015-09-08 Escape head on collisions
    [SCOB.ino]
2015-09-08 Backup if too close when wandering
    [SCOB.ino]
2015-09-08 WANDER command
    to switch into WANDER mode
2015-09-08 Reset mode before calling parseCommand
    otherwise modes can be changed by command
    [SCOB.ino]
2015-09-10 Experimental changes to make adding animations easier. No longer need to add cases in the switch statement, just define everything in the animation.
    [Animations.h, Config.h, SCOB.ino, ServoAnimator.h]
2015-09-10 Fix up issue with duplicate names for animations
    [Animations.h, Config.h]
2015-09-12 Report MAX_DISTANCE rather than zero for "inifinite" sonar readings.
2015-09-12 Report current servo centers if no parameters to SC command
2015-09-12 Fix bug in command parser so SS can be used over serial
    [Animations.h, Config.h, SCOB.ino]
2015-09-12 Fix issue in doCommand to make BK work again
    [SCOB.ino]
2015-09-15 Auto-switch between wander and random
    and gentler look left/right to stop him toppling over if the C of G is
    too high
    [Animations.h, SCOB.ino]
2015-09-17 Playing with head layout, adding hat
    trying to achieve a better fit for the battery pack
    [Final.scad, Hat.scad, Head.scad, Head.stl, machine.scad, moreShapes.scad, vitamins.scad]
2015-09-17 Finished hat, correct connector bug with head, rebuild
    [Final.scad, Hat.scad, Hat.stl, Head.scad]
2015-09-17 Flexy Arm
    [Final.scad, FlexyArm.scad, FlexyArm.stl, printedpart_FlexyArm.scad, printedparts.scad]
2015-09-17 Zombie SCOB
    [Final.scad, FlexyArm.scad, SCOBExtras.scad, ZombieArm.scad, ZombieArm.stl, printedpart_ZombieArm.scad, printedparts.scad, zombieSCOB.scad]
2015-09-18 Extra mouth holes
    to allow for more flexible/fun mouth arrangements, including neopixels
    (pin + wiring)
    [Head.scad, Head.stl]
2015-09-18 Make zombie arms the default
    [Final.scad, SCOBExtras.scad]
2015-09-18 Add finger notch to hat back panel
    to make it easier to get the hat off
    [Hat.scad, Hat.stl]
2015-09-18 Neo Pixel Vitamin library. Supports individual pixels and strips so far.
    [NeoPixel.scad, vitamins.scad]
2015-09-18 Fix up NeoPixel vitamin catalogue
    [NeoPixel.scad]
2015-09-18 Neo Pixel Mouth
    [Final.scad, NeoPixelMouth.scad, NeoPixelMouth.stl, assemblies.scad, assembly_NeoPixelMouth.scad, printedpart_NeoPixelMouth.scad, printedparts.scad]
2015-09-21 Extract ServoAnimator and SimpleBezier libraries
2015-09-21 Simple Random Arduino sketch
2015-09-26 Neopixel Animator classes for SCOB_fspm Also introduce do_<activity> methods to make switching state better(?)
2015-11-03 A Scob wifi controller sketch for the ESP8266 using the new SPIFFS filesystem code. You need to upload the contents of the data directory to the ESP8266 using the Arduino IDE plugin.
2015-11-08 Throttle sonar pings to try and reduce twitchy-ness
    [SCOB_fpsm.ino]
2015-11-09 Update Neopixel mouth so that it doesn't error in the build
    [NeoPixelMouth.scad]
2015-11-09 Update servo horn so it produces an stl during build.
    [ServoHorn.scad]
2015-11-10 Convert to the idea of having models for parts, with accessible properties to control joint angles, etc.
2015-11-10 Insert some hip servos
2015-11-10 Add some legs.
2015-12-31 Predefine functions to fix compile errors
    [SCOB.ino]
